ElGOATFilipino/TIDAL-KEYS/BOM.csv

Item Name | Qty (Actual used) | Qty (Bundle amount) | Value | Price (total) | Shipping fee? | Footprint | Item link | Additional notes
PCB | 1 | 5 | PCB | $21.70 | No | N/A | https://github.com/ElGOATFilipino/TIDAL-KEYS/blob/main/Production/Gerbers.zip
Capacitors, 100nf, 0805, ±5%, X7R | 20 | 20 | 100nF | $0.21 | No | Capacitor_SMD:C_0805_2012Metric | https://jlcpcb.com/partdetail/YAGEO-CC0805JRX7R9BB104/C111492
Diodes, 1N5819, 13A, 40V | 48 | 48 | D | $0.48 | No | Diode_SMD:D_SOD-123 | https://jlcpcb.com/partdetail/JSMSEMI-1N5819W/C963381
LEDs, neopixel, 3mA | 20 | 20 | SK6803MINI-E-001 | $1.71 | No | LED_SMD:LED_SK6812MINI-E_3.2x2.8mm_P1.5mm_ReverseMount | https://jlcpcb.com/partdetail/5951765-SK6803MINI_E001/C5242955
Resistors, 300Ω, 150V, ±1%, 0805 | 2 | 2 | 300 | $0.01 | No | Resistor_SMD:R_0805_2012Metric | https://jlcpcb.com/partdetail/YAGEO-RC0805FR07300RL/C114529
Cherry MX2A switches, Red, RGB, 5 pins, 70 pcs | 48 | 70 | SW_Push | $29.63 | No | Keyboard_stuff:SW_MX_HS_S_CPG151101S11_1u | https://es.aliexpress.com/item/1005008402977550.html?curPageLogUid=ZZCAVNHrM43p | Even though the keyboard only uses 50 pcs, I couldnt find any better deal, since buying separate combos still costs more than the 29.63 dollars
Kailh Hotswap sockets | 48 | 50 | SW_Push | $9.64 | No | Keyboard_stuff:SW_MX_HS_S_CPG151101S11_1u | https://es.aliexpress.com/item/1005007639688349.html?curPageLogUid=5NI5Xr7nHHgL
Seeed studio XIAO nrf52840 module, BLE | 2 | 2 | XIAO-nRF52840-SMD | $21.96 | Yes | Kicad_care_package:modified-XIAO-nRF52840-SMD | https://es.aliexpress.com/item/1005006988954136.html?scm_id=1007.40050.354490.0&scm-url=1007.40050.354490.0 | Shipping price=$6.61
Case components (all 3d printed) | 1 | 1 | Case components | $34 | No | N/A | https://github.com/ElGOATFilipino/TIDAL-KEYS/tree/main/CAD | Shipping price is included in the total price
LiPo Batteries, 1S, 3.7V, 1000mAh, 503450 | 2 | 2 | Batteries | $6.87 | No | N/A | https://es.aliexpress.com/item/1005013103110427.html?curPageLogUid=ZLGKQ38jfBzn
Keycaps, Dsa, 1u, white | 38 | 50 | 1u | $5.41 | No | N/A | https://es.aliexpress.com/item/1005010720096151.html?src=google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
Keycaps, DSA, 1.25u, white | 1 | 10 | 1.25u | $1.15 | No | N/A | https://es.aliexpress.com/item/1005008827506189.html?src=google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
Keycaps, DSA, 1.75u, white | 2 | 2 | 1.75u | $7.96 | No | N/A | https://es.aliexpress.com/item/4001241957677.html?gatewayAdapt=glo2esp
Keycaps, DSA, 2u, white | 2 | 10 | 2u | $4.27 | No | N/A | https://es.aliexpress.com/item/1005009085514680.html?curPageLogUid=b1AHBPyrZrdk
Keycaps, DSA, 2.25u, white | 1 | 3 | 2.25u | $8.42 | No | N/A | https://es.aliexpress.com/item/4001241957677.html?src=google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
Keycaps, DSA, 2.75u, white | 2 | 2 | 2.75u | $8.13 | No | N/A | https://es.aliexpress.com/item/4001241957677.html?src=google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
Keycap Stabilizer, 2u, Clip in, Cherry | 6 | 6 | Stabilizers | $7.20 | Yes | STAB_MX_2u & STAB_MX_ISO (see notes) | https://es.aliexpress.com/item/32864774665.html?gatewayAdapt=glo2esp | Shipping fee = $5.54
Screws, M2, 16mm, Pan Head, Phillips | 20 | 50 | Screws | $1.78 | No | MountingHole_2.2mm_M2 | https://es.aliexpress.com/item/1005007182988353.html?curPageLogUid=mBOUjEnW6mYq
Screws, M2, Self tapping, Pan Head, 4mm length | 4 | 50 | Screws | $1.09 | No | N/A | https://es.aliexpress.com/item/1005007288501133.html?curPageLogUid=unIipjr8vmr0
Heatset Inserts, Brass, M2, OD3.5mm, L4 | 20 | 50 | Heatset inserts | $1.09 | No | N/A | https://es.aliexpress.com/item/1005008666672949.html?src=google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 | This aliexpress link was actually listed previously on the blueprint ysws website.
Rubber mounts, 3x5x3mm | 12 | 50 | Spacers | $2.32 | Yes | N/A | https://es.aliexpress.com/item/1005011938076290.html?curPageLogUid=cPsdBSsDlQ6e | Shipping fee = $2.95
Rubber mounts, 3x5x2mm | 12 | 50 | Spacers | $1.90 | Yes | N/A | https://es.aliexpress.com/item/1005011938076290.html?curPageLogUid=cPsdBSsDlQ6e | Shipping fee = $2.95
Shipping fee total (Aliexpress) | N/A | N/A | Delivery | $18.05 | N/A | N/A | All items with "yes" listed in "shipping fee?"
Total | N/A | N/A | Total price | $194,98 | N/A | N/A | N/A
