ElGOATFilipino/TIDAL-KEYS/CAD/Assemblies/Full_assembly.step

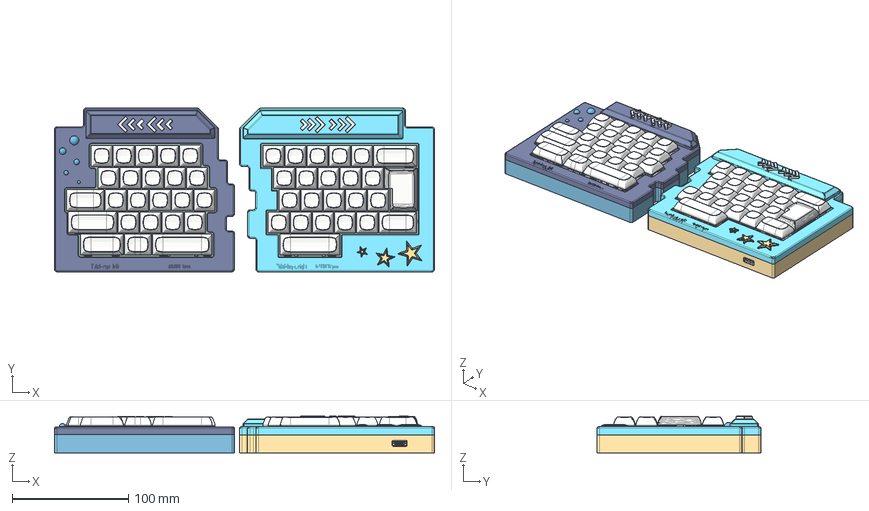
[picture p7: CAD file, 2026-10-30]
CAD/Assemblies/Full_assembly.step
327.0 x 140.8 x 31.6 mm
94459A120_Heat-Set Inserts for Plastic x 10
Bottom x 48
Pulsador x 48
Top x 48
Pieza5^Cherry MX x 48
Pin1_1 x 48
Pin2_1 x 48
Led 3mm_trans x 48
tidal 1
DSA V4 1x2.25 v3
DSA V4 1x1.25 v3 v4
DSA V4 1x2 v4 x 2
DSA V4 1x1.75 v4 x 2
mx Stabilizer base 16828 x 12
mx Stabilizer key 16828 x 12
metal stick 16828 x 6
ISO 7048 - Z - M2 x 16 Steel 4.6 Plain x 10
90380A324_Phillips Rounded Head Thread-Forming Screws
Pin1 x 10
Pin2 x 10
Pin3 x 10
Pin4 x 10
D_SOD-123 x 24
Tidal-keys_pad
Tidal-keys_PCB
C_0805_2012Metric x 10
Contact x 48
R_0805_2012Metric
BOSS-EXTRUDE14_8_
BOSS-EXTRUDE7_4_
BOSS-EXTRUDE7_3_
BOSS-EXTRUDE14_4_
BOSS-EXTRUDE14_2_
BOSS-EXTRUDE14_11_
BOSS-EXTRUDE7_7_
BOSS-EXTRUDE14_9_
BOSS-EXTRUDE14_3_
BOSS-EXTRUDE14_7_
MIRROR2
BOSS-EXTRUDE14_5_
BOSS-EXTRUDE14_12_
BOSS-EXTRUDE7_8_
BOSS-EXTRUDE7_1_
BOSS-EXTRUDE14_10_
BOSS-EXTRUDE7_9_
BOSS-EXTRUDE14_6_
BOSS-EXTRUDE14_1_
BOSS-EXTRUDE7_6_
BOSS-EXTRUDE7_2_
CUT-EXTRUDE5
BOSS-EXTRUDE7_5_
Shield
Pins
CAP x 2
ANT1
Silkscreen
CAP 3
LED
USR
DSA V4 1x2.75 v1 x 2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
