ElGOATFilipino/TIDAL-KEYS/CAD/Assemblies/Left-assembly.step

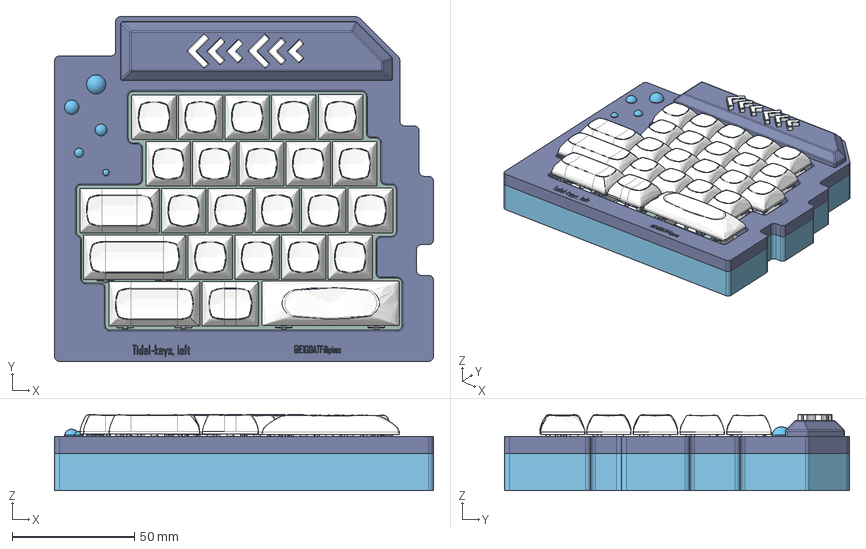
[picture p8: CAD file, 2026-10-29]
CAD/Assemblies/Left-assembly.step
154.8 x 140.8 x 31.1 mm
94459A120_Heat-Set Inserts for Plastic x 10
Bottom x 24
Pulsador x 24
Top x 24
Pieza5^Cherry MX x 24
Pin1 x 24
Pin2 x 24
Led 3mm_trans x 24
tidal 1
MX Mount v1
DSA V4 1x2.25 v3
DSA V4 1x1.25 v3 v4
DSA V4 1x2 v4
DSA V4 1x1.75 v4
mx Stabilizer base 16828 x 6
mx Stabilizer key 16828 x 6
metal stick 16828
metal stick 16828_1 x 2
ISO 7048 - Z - M2 x 17 Steel 4.6 Plain x 10
90380A324_Phillips Rounded Head Thread-Forming Screws x 2
Pin1_1 x 11
Pin2_1 x 11
Pin3 x 11
Pin4 x 11
D_SOD-123 x 24
Tidal-keys_pad
Tidal-keys_PCB
C_0805_2012Metric x 12
Contact x 48
R_0805_2012Metric
BOSS-EXTRUDE14_8_
BOSS-EXTRUDE7_4_
BOSS-EXTRUDE7_3_
BOSS-EXTRUDE14_4_
BOSS-EXTRUDE14_2_
BOSS-EXTRUDE14_11_
BOSS-EXTRUDE7_7_
BOSS-EXTRUDE14_9_
BOSS-EXTRUDE14_3_
BOSS-EXTRUDE14_7_
MIRROR2
BOSS-EXTRUDE14_5_
BOSS-EXTRUDE14_12_
BOSS-EXTRUDE7_8_
BOSS-EXTRUDE7_1_
BOSS-EXTRUDE14_10_
BOSS-EXTRUDE7_9_
BOSS-EXTRUDE14_6_
BOSS-EXTRUDE14_1_
BOSS-EXTRUDE7_6_
BOSS-EXTRUDE7_2_
CUT-EXTRUDE5
BOSS-EXTRUDE7_5_
Shield
Pins
CAP x 2
ANT1
Silkscreen
CAP 3
LED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
