ElGOATFilipino/TIDAL-KEYS/CAD/Right_split/Top_right.step

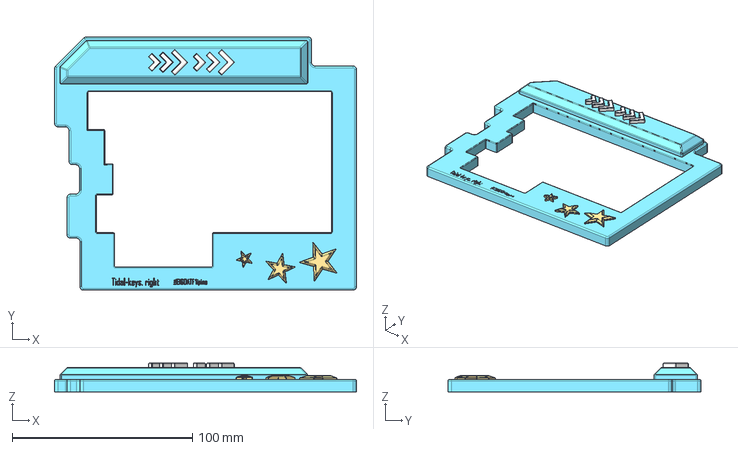
[picture p9: CAD file, 2026-10-26]
CAD/Right_split/Top_right.step
167.7 x 140.8 x 16.0 mm
