ElGOATFilipino/TIDAL-KEYS/(list of files, cad)

Other CAD files:
CAD/Assemblies/Right_assembly.step
