ElGOATFilipino/TIDAL-KEYS/PCB/Tidal-keys.kicad_pcb

## KiCad design PCB/Tidal-keys.kicad_pcb (2026-10-29)

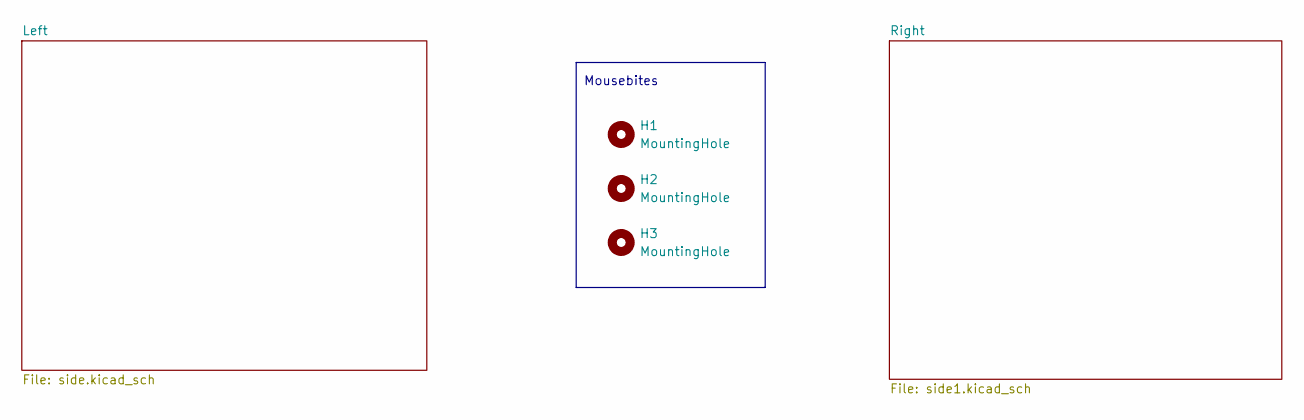
[picture p10: schematic Tidal-keys.kicad_sch]

Parts:
H1, H2, H3: MountingHole; mouse-bite-5mm-slot

Notes on the sheet:
Mousebites

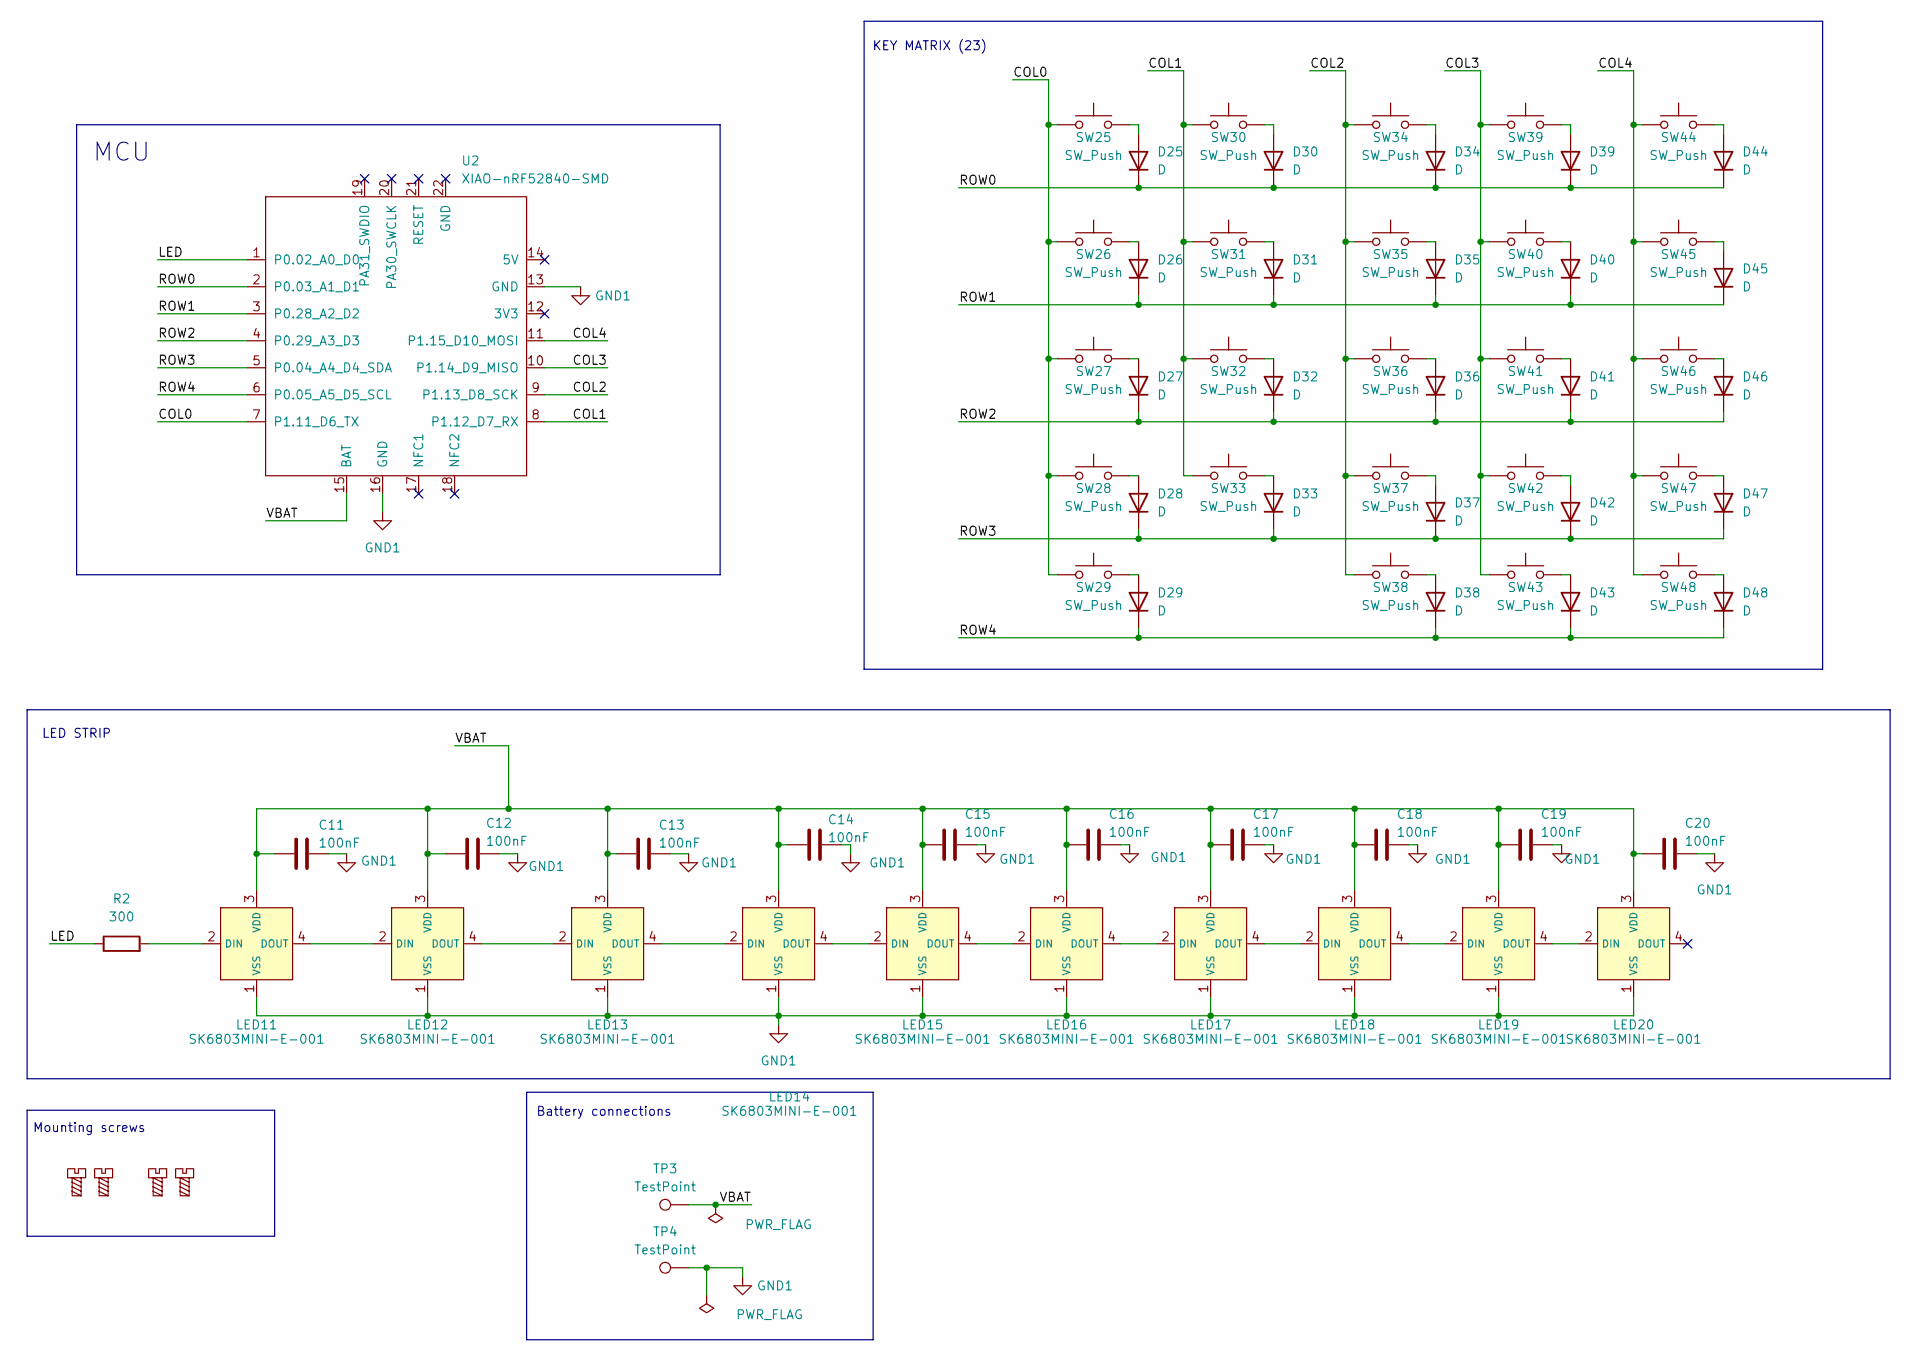
[picture p11: schematic side1.kicad_sch]

Parts:
C11, C12, C13, C14, C15, C16, C17, C18, C19, C20: 100nF; C_0805_2012Metric
D25, D26, D27, D28, D29, D30, D31, D32, D33, D34, D35, D36, D37, D38, D39, D40, D41, D42, D43, D44, D45, D46, D47, D48: D; D_SOD-123
H8, H9, H10, H11: MountingScrew; MountingHole_2.2mm_M2
LED11, LED12, LED13, LED14, LED15, LED16, LED17, LED18, LED19, LED20: SK6803MINI-E-001; LED_SK6812MINI-E_3.2x2.8mm_P1.5mm_ReverseMount; MPN SK6803MINI-E-001; LCSC Part C5242955
R2: 300; R_0805_2012Metric
SW25, SW26, SW27, SW28, SW29, SW30, SW31, SW32, SW33, SW34, SW35, SW36, SW37, SW38, SW39, SW40, SW41, SW42, SW43, SW44, SW45, SW46, SW47, SW48: SW_Push; SW_MX_HS_S_CPG151101S11_1u
TP3, TP4: TestPoint; TestPoint_Pad_D3.0mm
U2: XIAO-nRF52840-SMD; modified-XIAO-nRF52840-SMD

Connections:
/Right/COL0: SW25.1, SW26.1, SW27.1, SW28.1, SW29.1, U2.7 (P1.11_D6_TX)
/Right/COL1: SW30.1, SW31.1, SW32.1, SW33.1, U2.8 (P1.12_D7_RX)
/Right/COL2: SW34.1, SW35.1, SW36.1, SW37.1, SW38.1, U2.9 (P1.13_D8_SCK)
/Right/COL3: SW39.1, SW40.1, SW41.1, SW42.1, SW43.1, U2.10 (P1.14_D9_MISO)
/Right/COL4: SW44.1, SW45.1, SW46.1, SW47.1, SW48.1, U2.11 (P1.15_D10_MOSI)
/Right/LED: R2.1, U2.1 (P0.02_A0_D0)
/Right/ROW0: D25.1 (K), D30.1 (K), D34.1 (K), D39.1 (K), D44.1 (K), U2.2 (P0.03_A1_D1)
/Right/ROW1: D26.1 (K), D31.1 (K), D35.1 (K), D40.1 (K), D45.1 (K), U2.3 (P0.28_A2_D2)
/Right/ROW2: D27.1 (K), D32.1 (K), D36.1 (K), D41.1 (K), D46.1 (K), U2.4 (P0.29_A3_D3)
/Right/ROW3: D28.1 (K), D33.1 (K), D37.1 (K), D42.1 (K), D47.1 (K), U2.5 (P0.04_A4_D4_SDA)
/Right/ROW4: D29.1 (K), D38.1 (K), D43.1 (K), D48.1 (K), U2.6 (P0.05_A5_D5_SCL)
/Right/VBAT: C11.2, C12.2, C13.2, C14.2, C15.2, C16.2, C17.2, C18.2, C19.2, C20.2, LED11.3 (VDD), LED12.3 (VDD), LED13.3 (VDD), LED14.3 (VDD), LED15.3 (VDD), LED16.3 (VDD), LED17.3 (VDD), LED18.3 (VDD), LED19.3 (VDD), LED20.3 (VDD), TP3.1 (1_1), U2.15 (BAT)
GND1: C11.1, C12.1, C13.1, C14.1, C15.1, C16.1, C17.1, C18.1, C19.1, C20.1, LED11.1 (VSS), LED12.1 (VSS), LED13.1 (VSS), LED14.1 (VSS), LED15.1 (VSS), LED16.1 (VSS), LED17.1 (VSS), LED18.1 (VSS), LED19.1 (VSS), LED20.1 (VSS), TP4.1 (1_1), U2.13 (GND), U2.16 (GND)
unnamed: D25.2 (A), SW25.2
unnamed: D26.2 (A), SW26.2
unnamed: D27.2 (A), SW27.2
unnamed: D28.2 (A), SW28.2
unnamed: D29.2 (A), SW29.2
unnamed: D30.2 (A), SW30.2
unnamed: D31.2 (A), SW31.2
unnamed: D32.2 (A), SW32.2
unnamed: D33.2 (A), SW33.2
unnamed: D34.2 (A), SW34.2
unnamed: D35.2 (A), SW35.2
unnamed: D36.2 (A), SW36.2
unnamed: D37.2 (A), SW37.2
unnamed: D38.2 (A), SW38.2
unnamed: D39.2 (A), SW39.2
unnamed: D40.2 (A), SW40.2
unnamed: D41.2 (A), SW41.2
unnamed: D42.2 (A), SW42.2
unnamed: D43.2 (A), SW43.2
unnamed: D44.2 (A), SW44.2
unnamed: D45.2 (A), SW45.2
unnamed: D46.2 (A), SW46.2
unnamed: D47.2 (A), SW47.2
unnamed: D48.2 (A), SW48.2
unnamed: LED11.2 (DIN), R2.2
unnamed: LED11.4 (DOUT), LED12.2 (DIN)
unnamed: LED12.4 (DOUT), LED13.2 (DIN)
unnamed: LED13.4 (DOUT), LED14.2 (DIN)
unnamed: LED14.4 (DOUT), LED15.2 (DIN)
unnamed: LED15.4 (DOUT), LED16.2 (DIN)
unnamed: LED16.4 (DOUT), LED17.2 (DIN)
unnamed: LED17.4 (DOUT), LED18.2 (DIN)
unnamed: LED18.4 (DOUT), LED19.2 (DIN)
unnamed: LED19.4 (DOUT), LED20.2 (DIN)

Notes on the sheet:
Mounting screws
MCU
Battery connections
LED STRIP
KEY MATRIX (23)

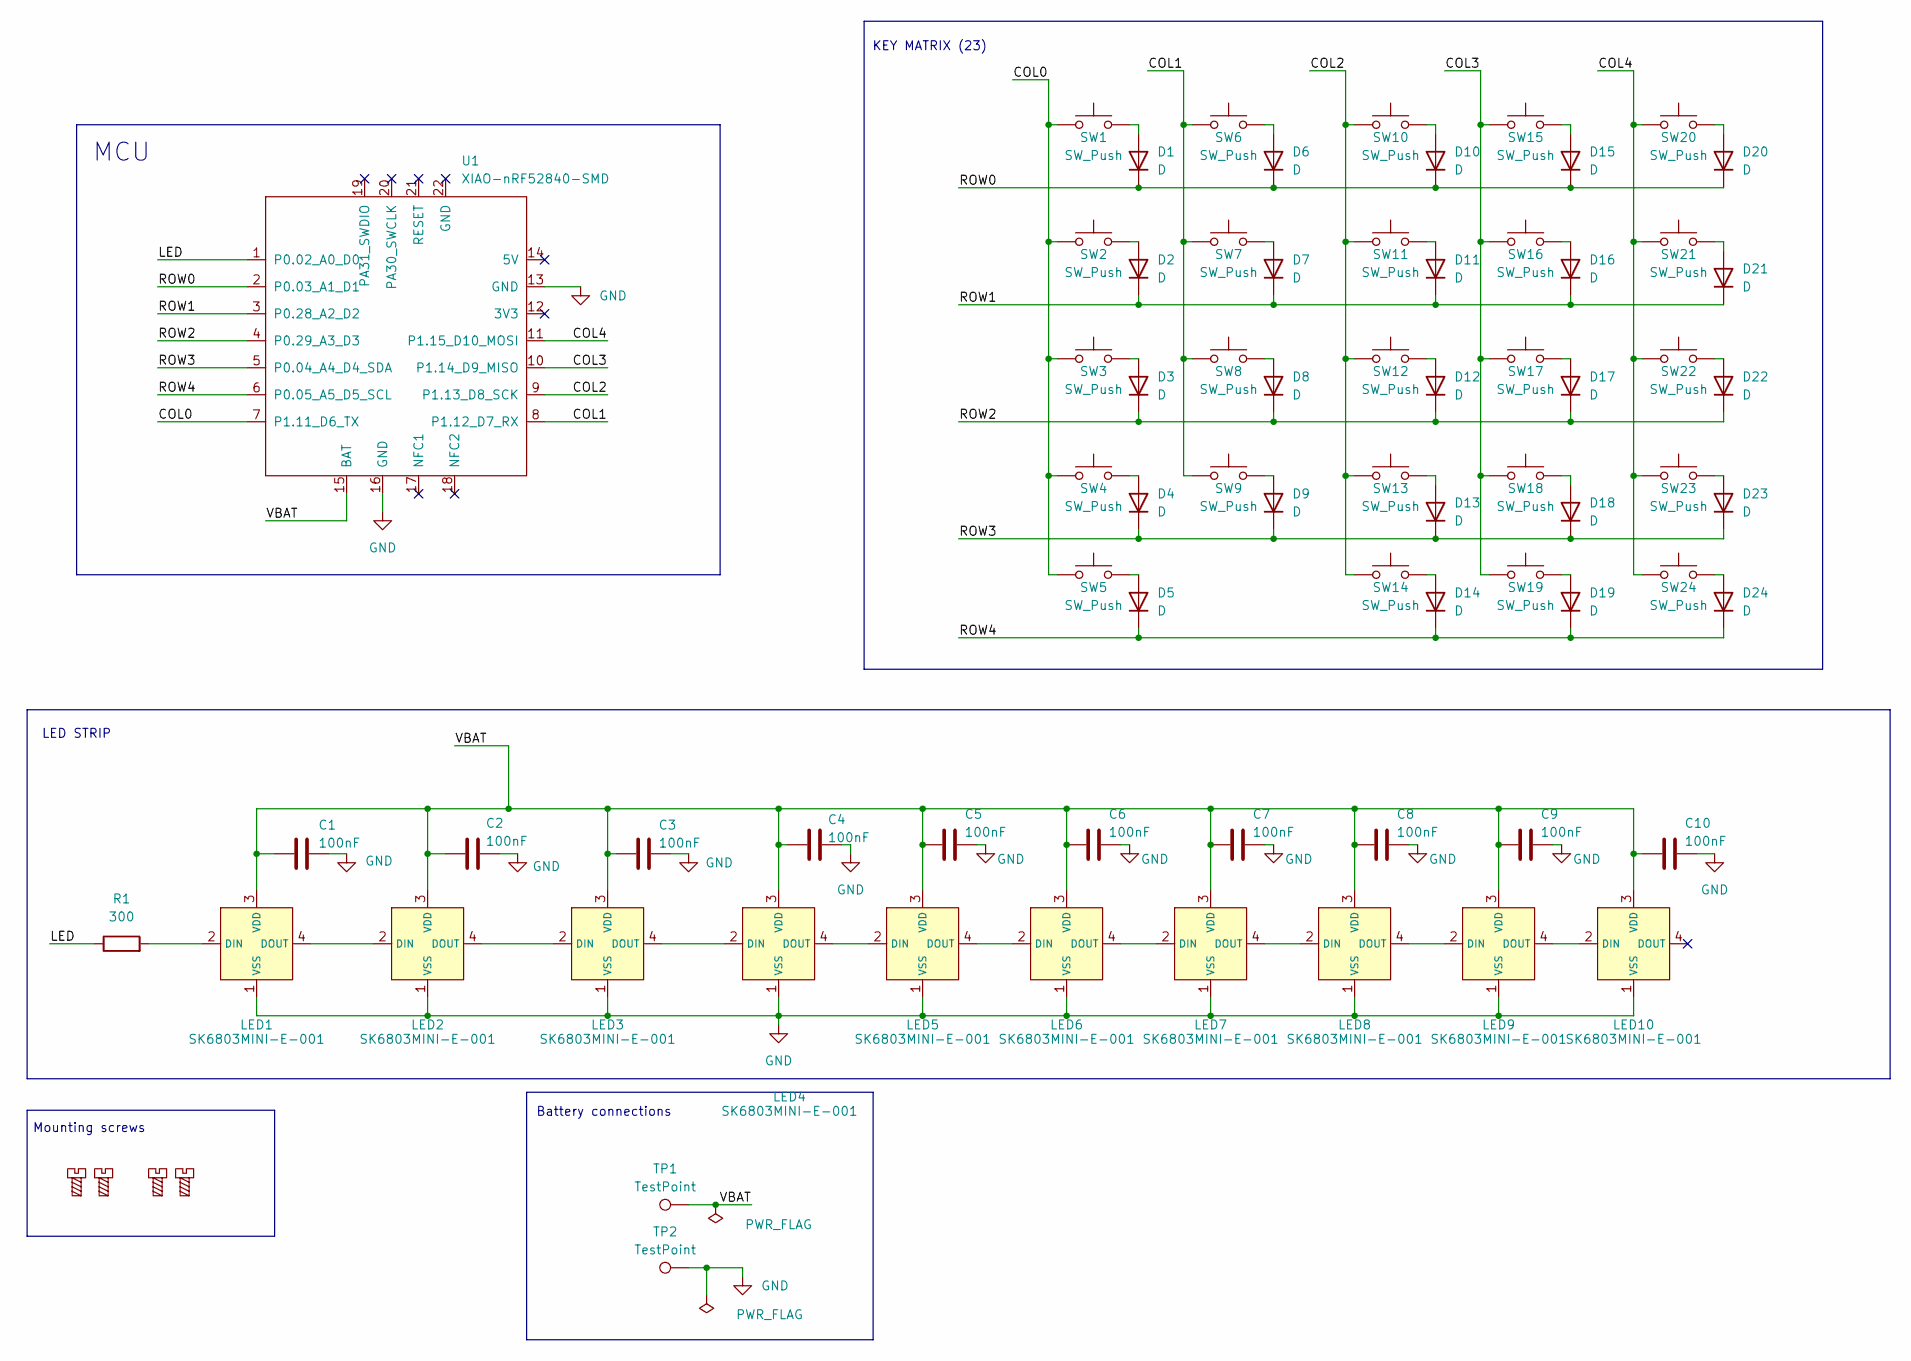
[picture p12: schematic side.kicad_sch]

Parts:
C1, C2, C3, C4, C5, C6, C7, C8, C9, C10: 100nF; C_0805_2012Metric
D1, D2, D3, D4, D5, D6, D7, D8, D9, D10, D11, D12, D13, D14, D15, D16, D17, D18, D19, D20, D21, D22, D23, D24: D; D_SOD-123
H4, H5, H6, H7: MountingScrew; MountingHole_3.2mm_M3
LED1, LED2, LED3, LED4, LED5, LED6, LED7, LED8, LED9, LED10: SK6803MINI-E-001; LED_SK6812MINI-E_3.2x2.8mm_P1.5mm_ReverseMount; MPN SK6803MINI-E-001; LCSC Part C5242955
R1: 300; R_0805_2012Metric
SW1, SW2, SW3, SW4, SW5, SW6, SW7, SW8, SW9, SW10, SW11, SW12, SW13, SW14, SW15, SW16, SW17, SW18, SW19, SW20, SW21, SW22, SW23, SW24: SW_Push; SW_MX_HS_S_CPG151101S11_1u
TP1, TP2: TestPoint; TestPoint_Pad_D3.0mm
U1: XIAO-nRF52840-SMD; modified-XIAO-nRF52840-SMD

Connections:
/Left/COL0: SW1.1, SW2.1, SW3.1, SW4.1, SW5.1, U1.7 (P1.11_D6_TX)
/Left/COL1: SW6.1, SW7.1, SW8.1, SW9.1, U1.8 (P1.12_D7_RX)
/Left/COL2: SW10.1, SW11.1, SW12.1, SW13.1, SW14.1, U1.9 (P1.13_D8_SCK)
/Left/COL3: SW15.1, SW16.1, SW17.1, SW18.1, SW19.1, U1.10 (P1.14_D9_MISO)
/Left/COL4: SW20.1, SW21.1, SW22.1, SW23.1, SW24.1, U1.11 (P1.15_D10_MOSI)
/Left/LED: R1.1, U1.1 (P0.02_A0_D0)
/Left/ROW0: D1.1 (K), D6.1 (K), D10.1 (K), D15.1 (K), D20.1 (K), U1.2 (P0.03_A1_D1)
/Left/ROW1: D2.1 (K), D7.1 (K), D11.1 (K), D16.1 (K), D21.1 (K), U1.3 (P0.28_A2_D2)
/Left/ROW2: D3.1 (K), D8.1 (K), D12.1 (K), D17.1 (K), D22.1 (K), U1.4 (P0.29_A3_D3)
/Left/ROW3: D4.1 (K), D9.1 (K), D13.1 (K), D18.1 (K), D23.1 (K), U1.5 (P0.04_A4_D4_SDA)
/Left/ROW4: D5.1 (K), D14.1 (K), D19.1 (K), D24.1 (K), U1.6 (P0.05_A5_D5_SCL)
/Left/VBAT: C1.2, C2.2, C3.2, C4.2, C5.2, C6.2, C7.2, C8.2, C9.2, C10.2, LED1.3 (VDD), LED2.3 (VDD), LED3.3 (VDD), LED4.3 (VDD), LED5.3 (VDD), LED6.3 (VDD), LED7.3 (VDD), LED8.3 (VDD), LED9.3 (VDD), LED10.3 (VDD), TP1.1 (1_1), U1.15 (BAT)
GND: C1.1, C2.1, C3.1, C4.1, C5.1, C6.1, C7.1, C8.1, C9.1, C10.1, LED1.1 (VSS), LED2.1 (VSS), LED3.1 (VSS), LED4.1 (VSS), LED5.1 (VSS), LED6.1 (VSS), LED7.1 (VSS), LED8.1 (VSS), LED9.1 (VSS), LED10.1 (VSS), TP2.1 (1_1), U1.13 (GND), U1.16 (GND)
unnamed: D1.2 (A), SW1.2
unnamed: D2.2 (A), SW2.2
unnamed: D3.2 (A), SW3.2
unnamed: D4.2 (A), SW4.2
unnamed: D5.2 (A), SW5.2
unnamed: D6.2 (A), SW6.2
unnamed: D7.2 (A), SW7.2
unnamed: D8.2 (A), SW8.2
unnamed: D9.2 (A), SW9.2
unnamed: D10.2 (A), SW10.2
unnamed: D11.2 (A), SW11.2
unnamed: D12.2 (A), SW12.2
unnamed: D13.2 (A), SW13.2
unnamed: D14.2 (A), SW14.2
unnamed: D15.2 (A), SW15.2
unnamed: D16.2 (A), SW16.2
unnamed: D17.2 (A), SW17.2
unnamed: D18.2 (A), SW18.2
unnamed: D19.2 (A), SW19.2
unnamed: D20.2 (A), SW20.2
unnamed: D21.2 (A), SW21.2
unnamed: D22.2 (A), SW22.2
unnamed: D23.2 (A), SW23.2
unnamed: D24.2 (A), SW24.2
unnamed: LED1.2 (DIN), R1.2
unnamed: LED1.4 (DOUT), LED2.2 (DIN)
unnamed: LED2.4 (DOUT), LED3.2 (DIN)
unnamed: LED3.4 (DOUT), LED4.2 (DIN)
unnamed: LED4.4 (DOUT), LED5.2 (DIN)
unnamed: LED5.4 (DOUT), LED6.2 (DIN)
unnamed: LED6.4 (DOUT), LED7.2 (DIN)
unnamed: LED7.4 (DOUT), LED8.2 (DIN)
unnamed: LED8.4 (DOUT), LED9.2 (DIN)
unnamed: LED9.4 (DOUT), LED10.2 (DIN)

Notes on the sheet:
MCU
Battery connections
LED STRIP
Mounting screws
KEY MATRIX (23)

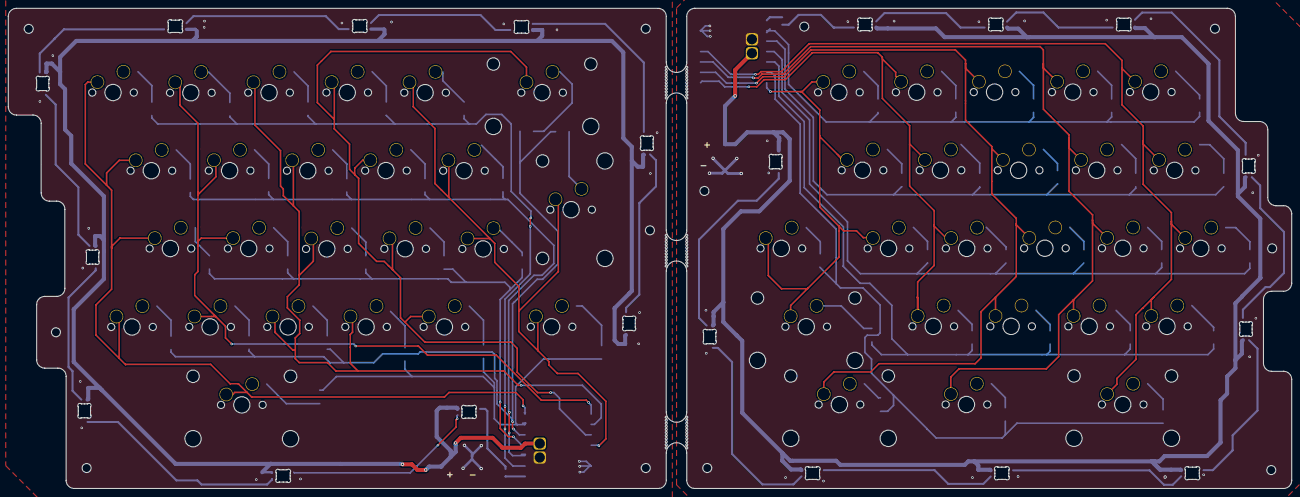
[picture p13: board Tidal-keys.kicad_pcb from above]

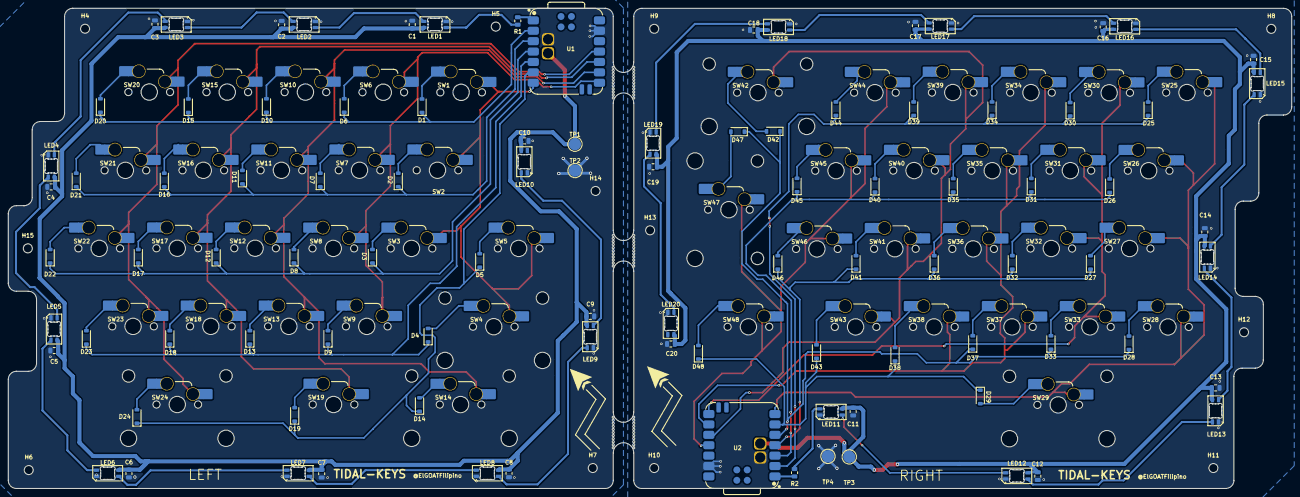
[picture p14: board Tidal-keys.kicad_pcb from below]

Board: 2 copper layers, 313.5 x 117.3 mm, 159 parts (159 on the bottom side), 94 nets.

Other parts of the board:
H12, H13, H14, H15: MountingScrew; MountingHole_2.2mm_M2
