ElGOATFilipino/TIDAL-KEYS/(commit log)

2026-09-07 Adding circuit files
    [Tidal-keys(MAIN).kicad_sch, Tidal-keys.kicad_pcb, side.kicad_sch, side1.kicad_sch]
2026-09-07 Addding circuit
    [Tidal-keys(MAIN).kicad_sch, Tidal-keys.kicad_pcb, side.kicad_sch, side1.kicad_sch]
2026-10-17 Add Batlid-left.step to Left_split directory
    [Batlid-left.step]
2026-10-17 Add Top left.step to Left_split directory
    [Top left.step]
2026-10-17 Add Bottom-right.step to Right_split directory
    [Bottom-right.step]
2026-10-18 Adding full assembly
    wew
    [Full-keyboard.step]
2026-10-18 Adding .pro and .pcb files
    [Tidal-keys.kicad_pcb]
2026-10-18 Update README with detailed 3D printing information
    Clarified the description of the keyboard design to specify which parts are meant for 3D printing.
2026-10-20 Adding gerber
2026-10-25 Squashed 'firmware/' content from commit 1473276
    git-subtree-dir: firmware
    git-subtree-split: 1473276d6ea2c543b34d7c57e7d4a57802eed480
    [Batlid-left.step, Batlid-right.step, Bottom-left.step, Bottom-right.step, Full-keyboard.step, Left-assembly.step, Right-assembly.step, Tidal-keys.kicad_pcb]
2026-10-26 Updated top lids
    [Top_left.step, Top_right.step]
2026-10-28 Adding full file
    [Full-split.step]
2026-10-30 Adding updated full assembly
    [Full_assembly.step]
2026-10-30 Adding extra decription to PCB, also fixing a typo I left at the start of the header
    Updated PCB section to clarify design details and component usage.
2026-10-30 Fixing incorrect spacer dimensions in readme
    Corrected the top spacer size for the battery lid assembly.
